AAEONAEU-SW/AAEON-LoRa-End-Node/documents_and_guides/cables/STLINK/IMG_7380.JPG

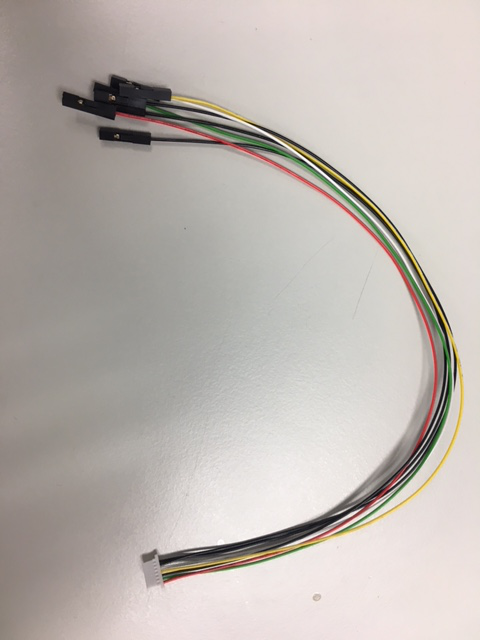
documents_and_guides/cables/STLINK/IMG_7380.JPG
