AAEONAEU-SW/AAEON-LoRa-End-Node/documents_and_guides/cables/STLINK/IMG_7379.JPG

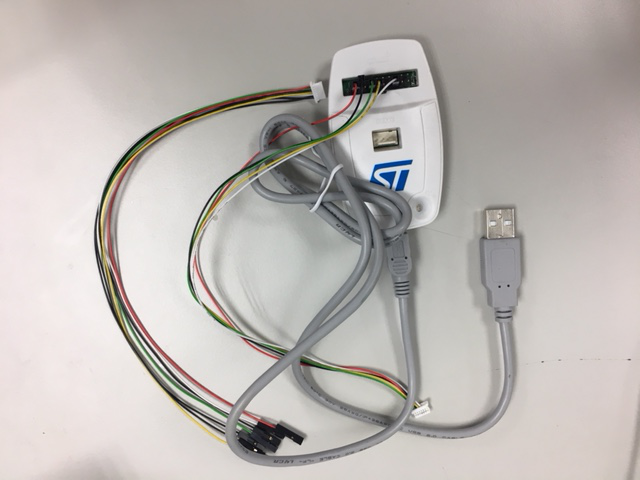
documents_and_guides/cables/STLINK/IMG_7379.JPG
