AAEONAEU-SW/AAEON-LoRa-End-Node/README.md

# AAEON-LoRa-End-Node

Available documentation:

- certifications
- documents and guides
- drawings
- software
- test_reports
