AAEONAEU-SW/AAEON-LoRa-End-Node/drawings/README.md

# Documents available in this section

Board and Plastic Enclosure drawings
