AAEONAEU-SW/AAEON-LoRa-End-Node/drawings/board/loranode_mpcba_20190329.pdf

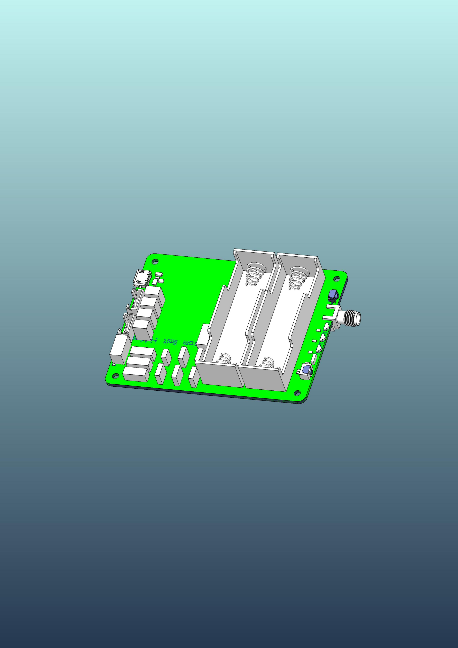
[picture p3: page 1]
