AAEONAEU-SW/AAEON-LoRa-End-Node/drawings/plastic_enclosure/3D/loranode_-108-02-19.stp

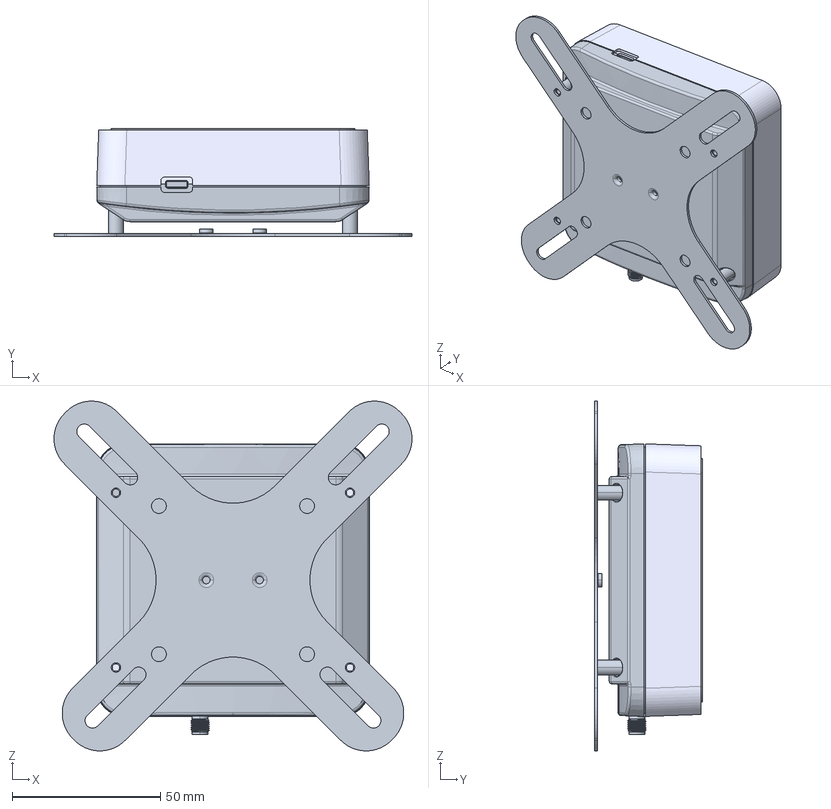
[picture p4: CAD file, 2019-04-25]
drawings/plastic_enclosure/3D/loranode_-108-02-19.stp
120.8 x 36.5 x 118.0 mm
GUSCIO_SUPERIORE_2_13_17_3_1_13
GUSCIO_INFERIORE_1_2_2_2_1_1_1
COPERCHIO_LOGO_1_12_8_2_1_6_1
PUSH-PUSH_SWITCH_1_1_2_2_2_2_1_
PRT0035_1_2_1_1_1
PRT0036_1_2_1_1_1 x 3
PRT0038_1_2_1_1_1
PRT0039_1_2_1_1_1 x 2
PRT0040_1_2_1_1_1
PRT0041_1_2_1_1_1 x 2
PRT0042_1_2_1_1_1
PRT0043_1_2_1_1_1 x 3
PRT0044_1_2_1_1_1 x 2
PRT0045_1_2_1_1_1 x 16
PRT0046_1_2_1_1_1
PRT0047_1_2_1_1_1
PRT0048_1_2_1_1_1 x 4
PRT0049_1_2_1_1_1
PRT0050_1_2_1_1_1 x 34
PRT0051_1_2_1_1_1
PRT0052_1_2_1_1_1 x 3
PRT0053_1_2_1_1_1 x 12
PRT0054_1_2_1_1_1 x 23
PRT0055_1_2_1_1_1 x 5
PRT0056_1_2_1_1_1
PRT0057_1_2_1_1_1
PRT0058_1_2_1_1_1 x 4
PRT0059_1_2_1_1_1
PRT0060_1_2_1_1_1 x 2
PRT0061_1_2_1_1_1
PRT0062_1_2_1_1_1
PRT0063_1_2_1_1_1
PRT0064_1_2_1_1_1
PRT0065_1_2_1_1_1
PRT0066_1_2_1_1_1
PRT0067_1_2_1_1_1
PRT0068_1_2_1_1_1
TOP_2_2_1_1_1
SMA-A3480010300_3_1_2_1_1_1
MANIFOLD_SOLID_BREP_32340_1_2_1
LEM-87_3_2_1_1_1 x 4
CNX_RUBBER_3_1 x 4
PRT0001
STADOFF_2 x 4
