AAEONAEU-SW/AAEON-LoRa-End-Node/documents_and_guides/cables/STLINK/FWAA-1114 SPEC(JackyTing).pdf

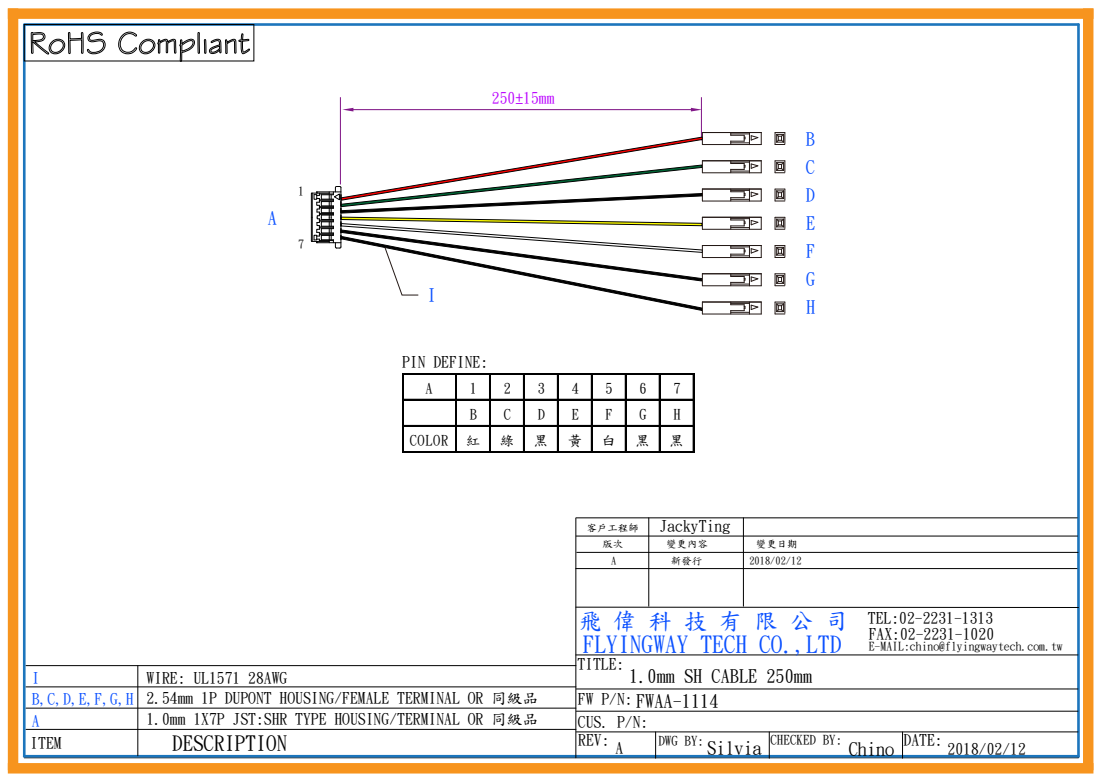
[picture p5: page 1]
PIN DEFINE:

COLOR | 紅 | 綠 | 黑 | 黃 | 白 | 黑 | 黑

客戶工程師 | JackyTing

版次 | 變更內容 | 變更日期
A | 新發行 | 2018/02/12

FLYINGWAY TECH CO.,LTD
TITLE:
1.0mm SH CABLE 250mm

TEL:02-2231-1313
FAX:02-2231-1020
E-MAIL:chino@flyingwaytech.com.tw

I | WIRE: UL1571 28AWG
B,C,D,E,F,G,H | 2.54mm 1P DUPONT HOUSING/FEMALE TERMINAL OR 同級品 | FW P/N: FWAA-1114
A | 1.0mm 1X7P JST:SHR TYPE HOUSING/TERMINAL OR 同級品 | CUS. P/N:
ITEM | DESCRIPTION | REV: | DWG BY: Silvia | CHECKED BY: A Chino | DATE: 2018/02/12
