AAEONAEU-SW/AAEON-LoRa-End-Node/drawings/plastic_enclosure/2D/loranode-108-02-19.pdf

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

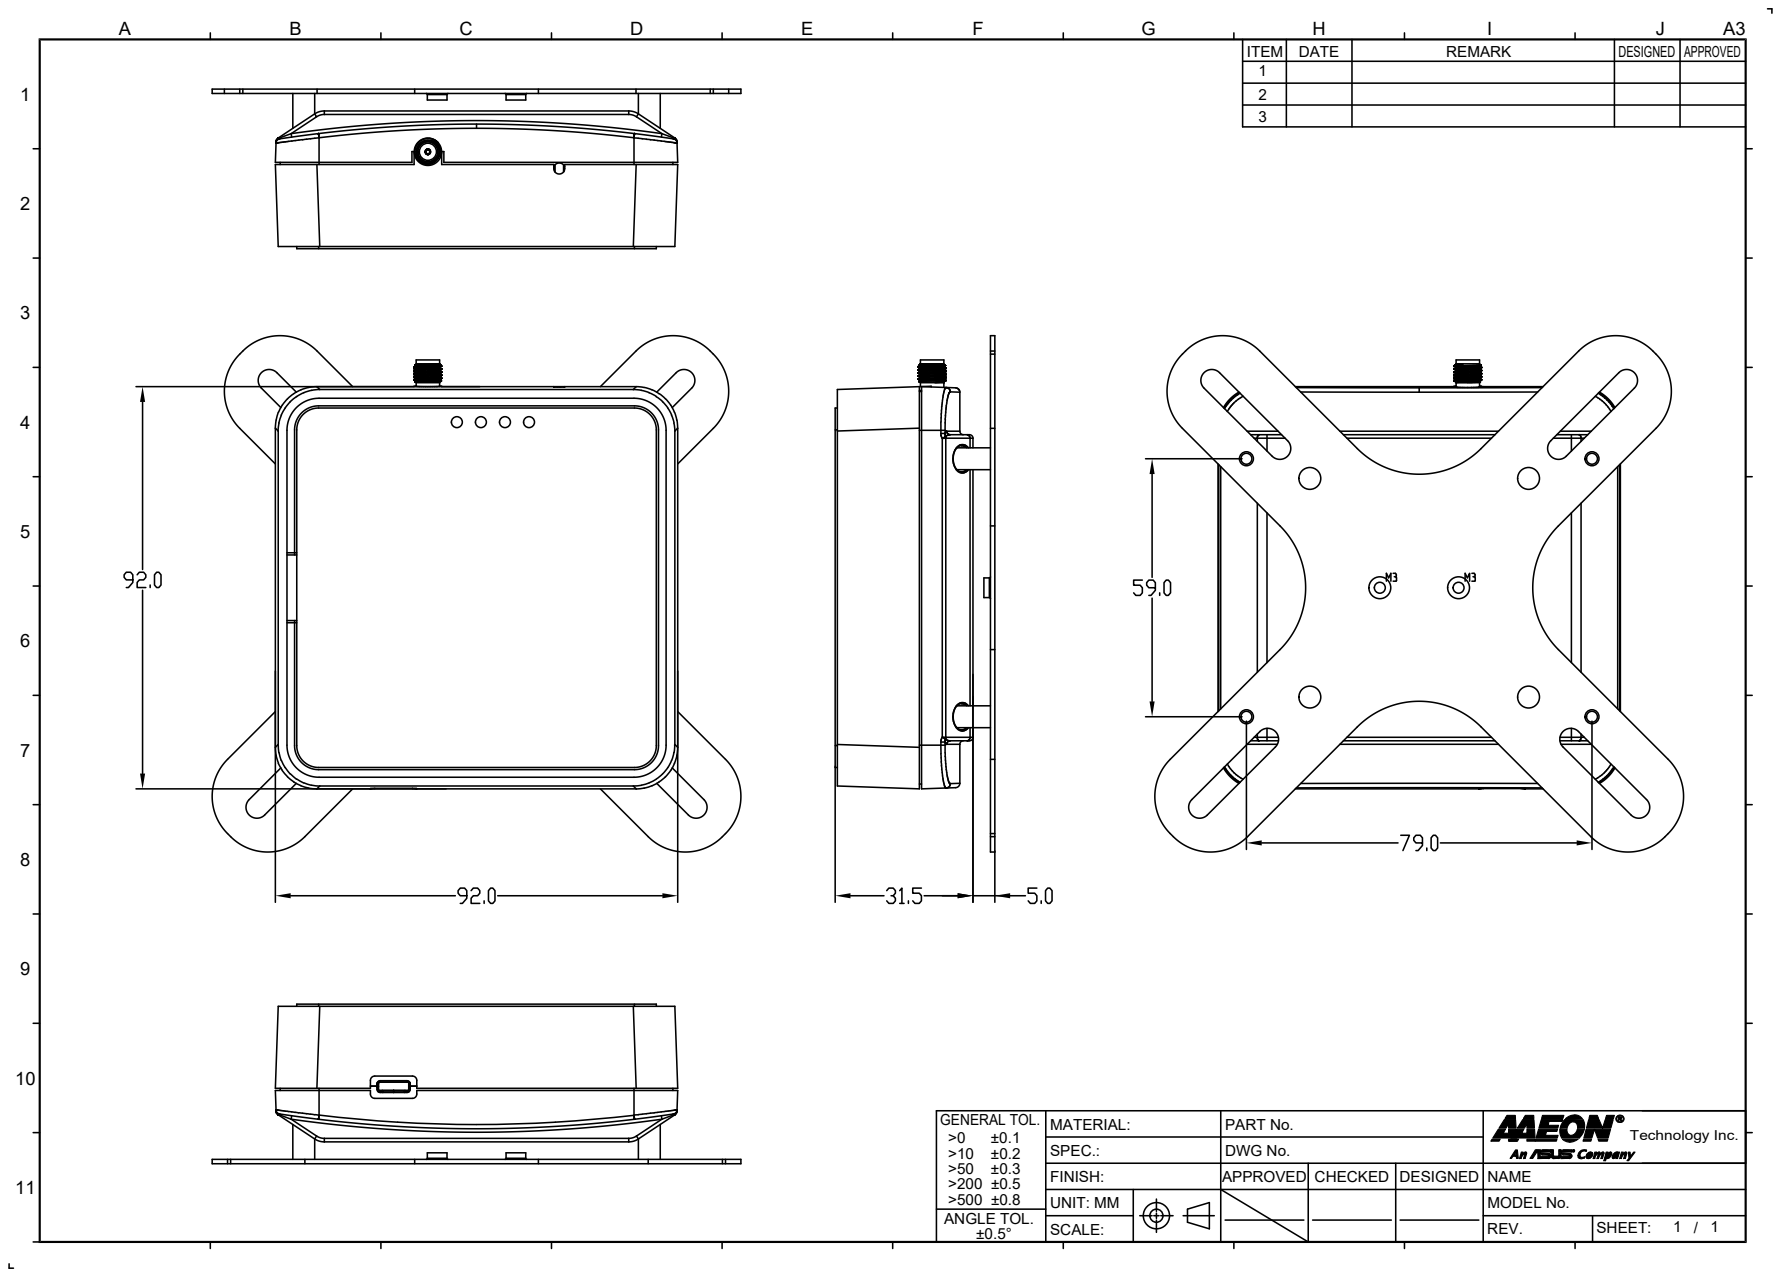
[picture p6: page 1]
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
