AAEONAEU-SW/AAEON-LoRa-End-Node/documents_and_guides/README.md

# Documents available in this section

- QIG
- User's Manual: AIOT-ILND01 Manual 1st Ed 0327.pdf
- Datasheet: AIOT-ILND01.pdf
- Cables (folder)
- Power consumption: power consumption.txt
