AAEONAEU-SW/AAEON-LoRa-End-Node/documents_and_guides/cables/cable layout for STLINK.png

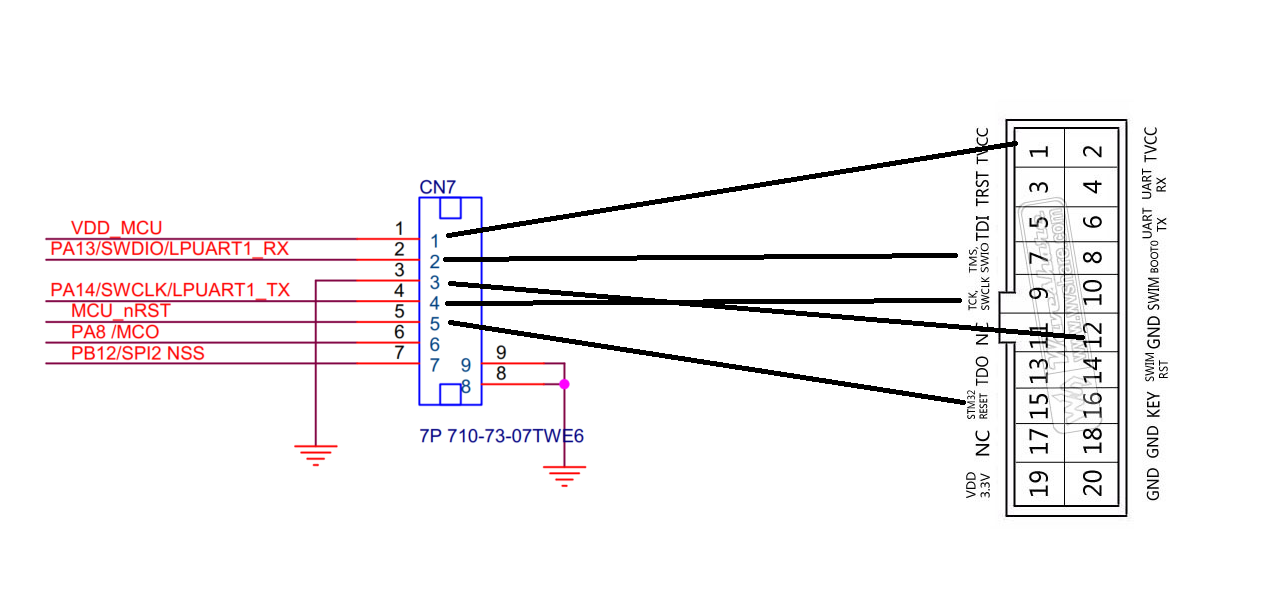
documents_and_guides/cables/cable layout for STLINK.png
