AAEONAEU-SW/AAEON-LoRa-End-Node/documents_and_guides/cables/ST-LINK APP Settings.JPG

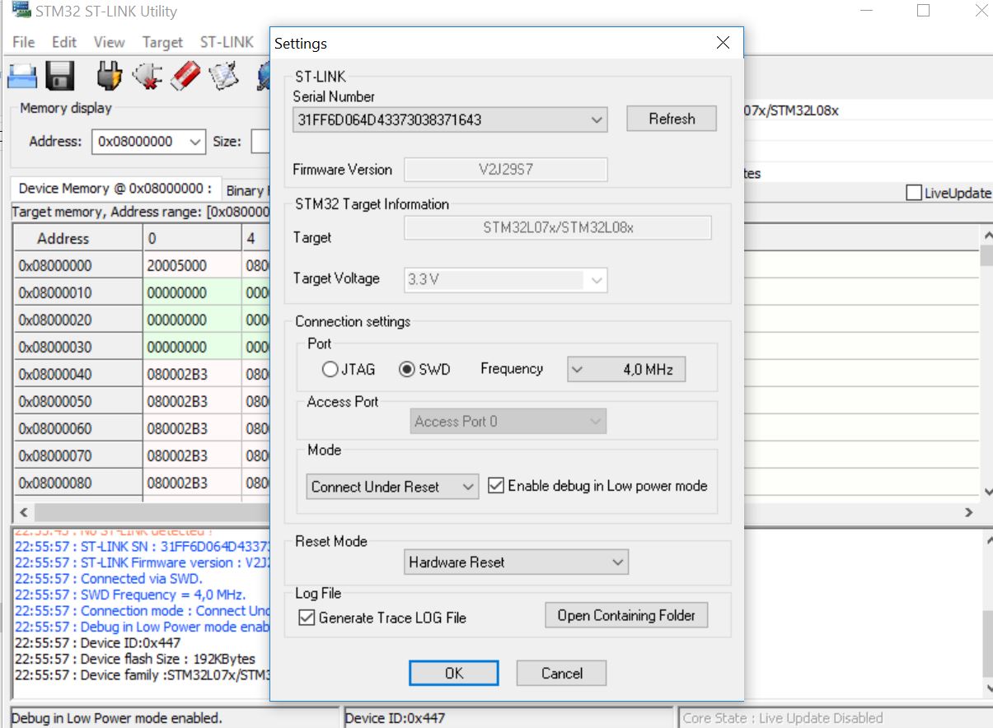
documents_and_guides/cables/ST-LINK APP Settings.JPG
