AAEONAEU-SW/AAEON-LoRa-End-Node/documents_and_guides/cables/STLINK/usb serial.jpg

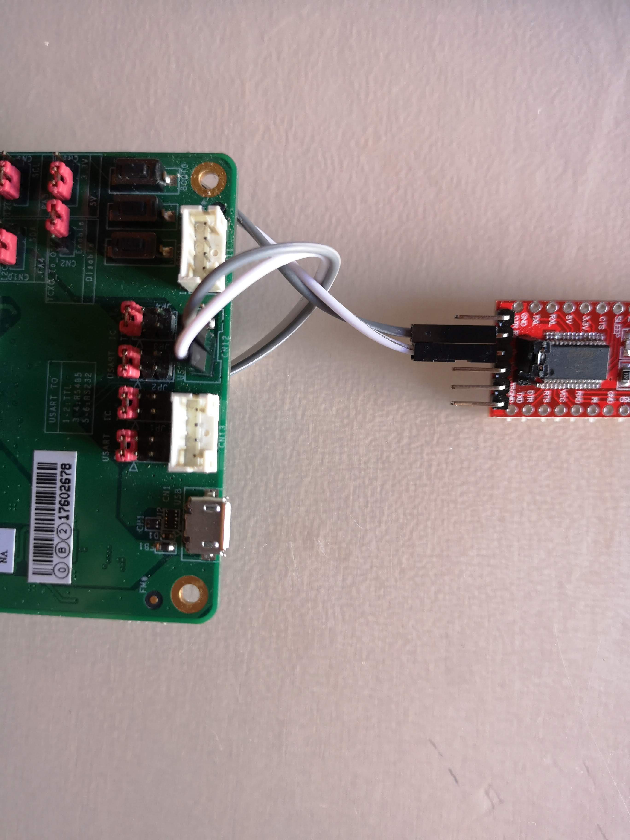
documents_and_guides/cables/STLINK/usb serial.jpg
