AAEONAEU-SW/AAEON-LoRa-End-Node/test_reports/README.md

# Documents available in this section

Test and Validation reports
