AAEONAEU-SW/AAEON-LoRa-End-Node/test_reports/LORA_RS232 485 Problem.jpg

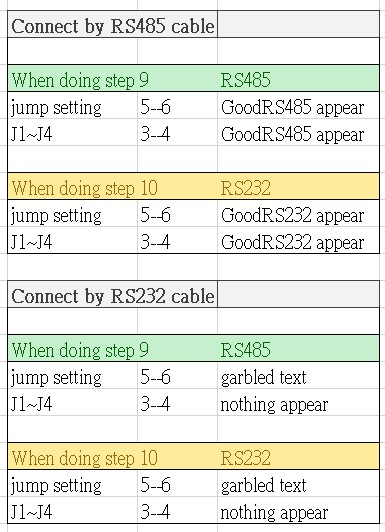
test_reports/LORA_RS232 485 Problem.jpg
